stnolting/74xx_discrete_clock/schematic/clock_module.pdf

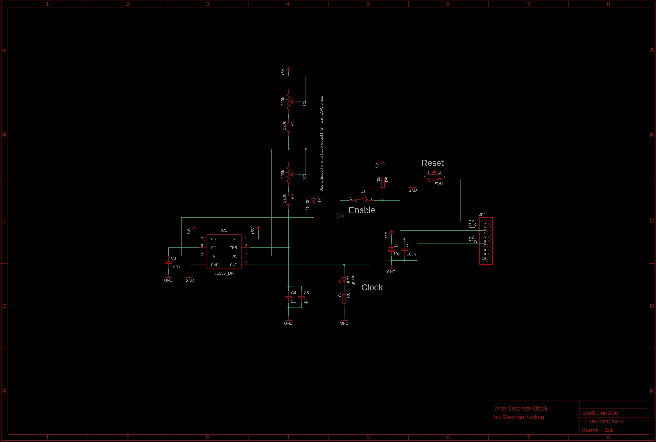
[picture p13: page 1]
