stnolting/74xx_discrete_clock/schematic/counter_module.pdf

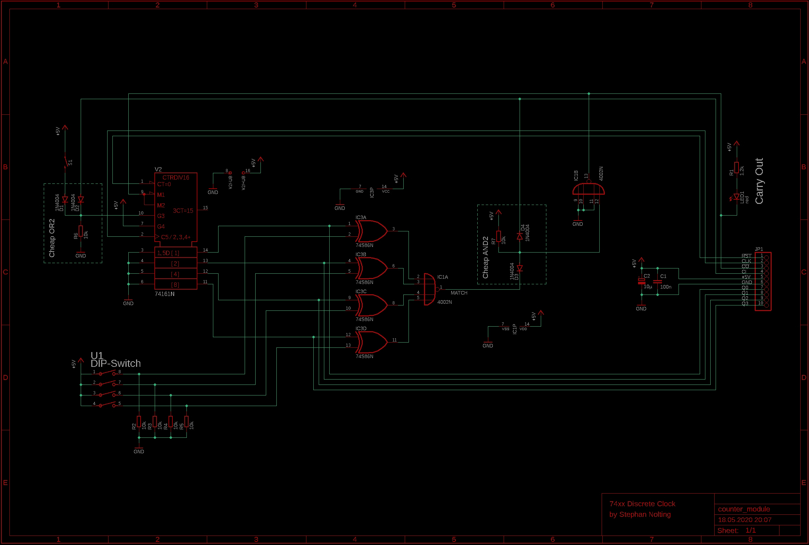
[picture p14: page 1]
