stnolting/74xx_discrete_clock/schematic/display_board.pdf

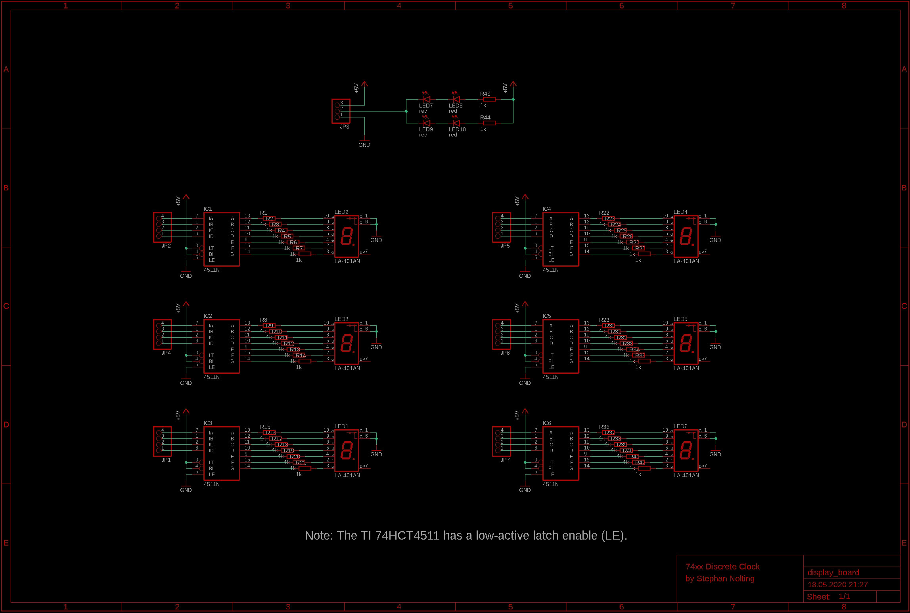
[picture p15: page 1]
