stnolting/74xx_discrete_clock/schematic/mother_board.pdf

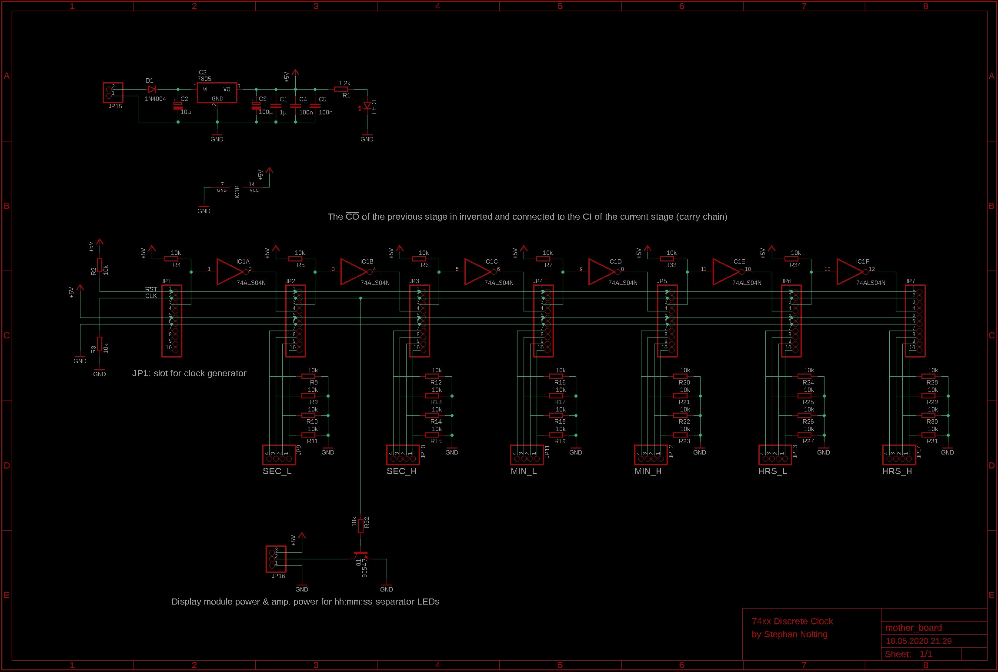
[picture p16: page 1]
