stnolting/74xx_discrete_clock/schematic/counter_module.png

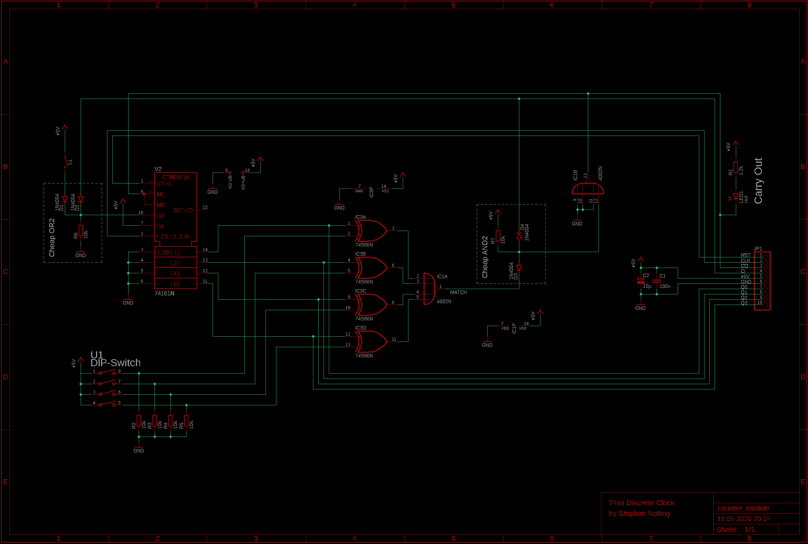
schematic/counter_module.png
