stnolting/74xx_discrete_clock/schematic/clock_module.sch

## EAGLE design schematic/clock_module.sch (2020-05-19)

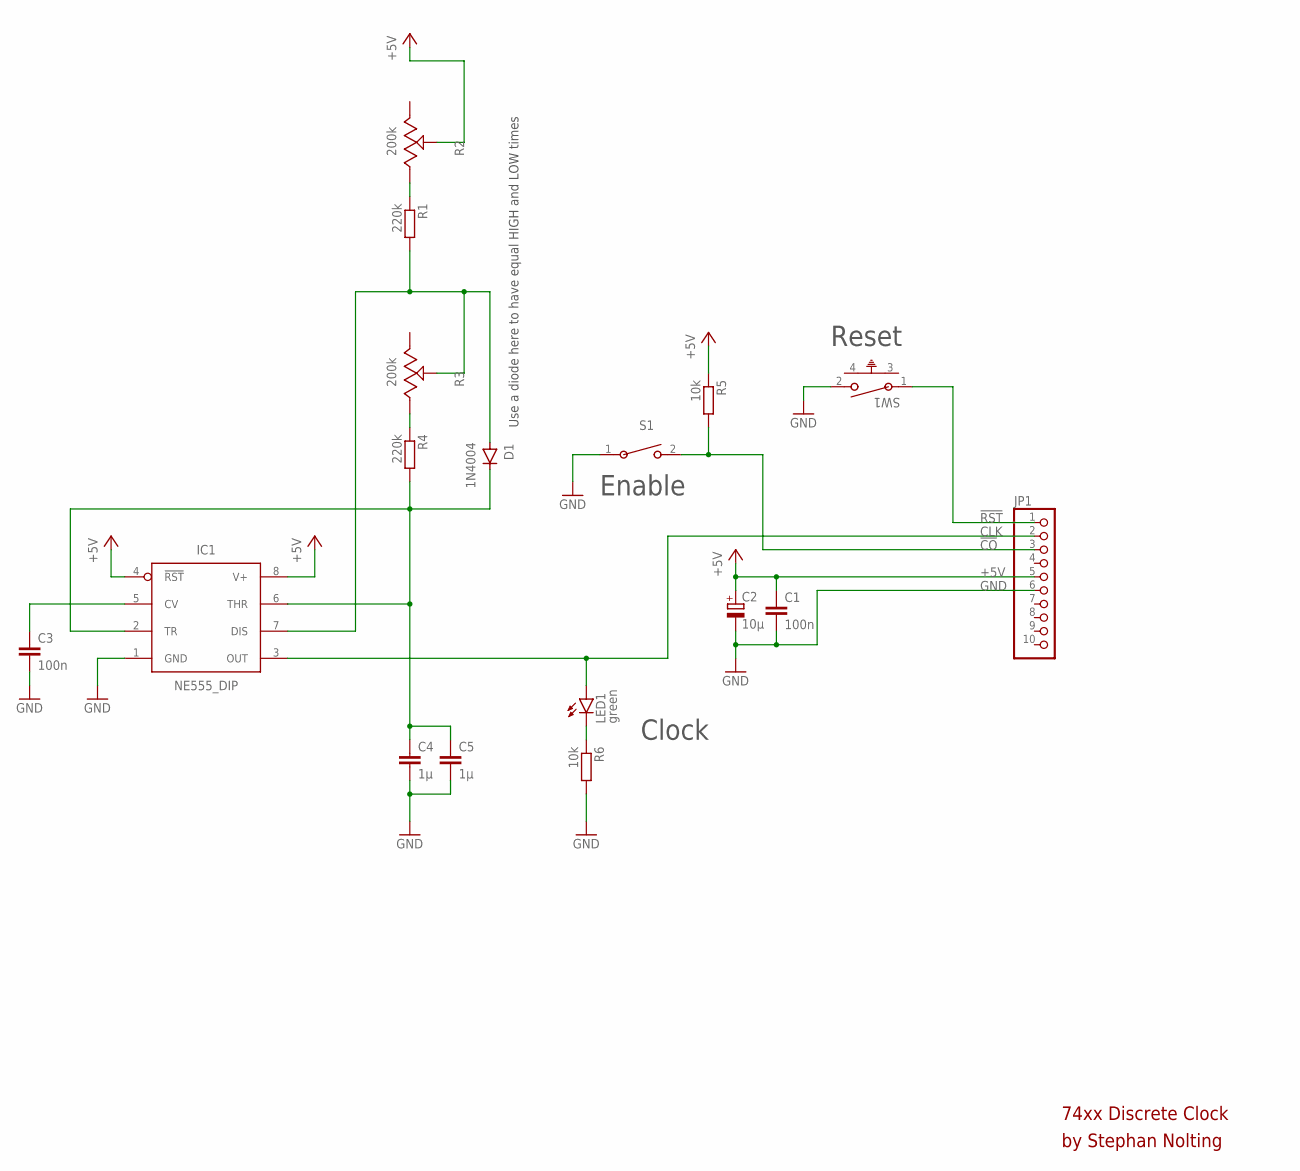
[picture p18: schematic clock_module.sch]

Parts:
C1, C3: 100n; C025-024X044
C2: 10µ; E2-5
C4, C5: 1µ; C025-024X044
D1: 1N4004; DO-41
IC1: NE555_DIP; DIP826W53P254L959H508Q8B
JP1: PINHD-1X10/90; 1X10/90
LED1: green; LED3MM
R1, R4: 220k; 0204/7
R2, R3: 200k; 3310Y-001-104L-ND
R5, R6: 10k; 0204/7
S1: 1825966-1; SWDIP2_256X170P100
SW1: 1-1825027-4; SW2_1825027-E

Connections:
!CO: JP1.3, R5.2, S1.2
!RST: JP1.1, SW1.1
+5V: C1.1, C2.+, IC1.4 (!RST), IC1.8 (V+), JP1.5, R2.2, R5.1
CLK: IC1.3 (OUT), JP1.2, LED1.A
GND: C1.2, C2.-, C3.2, C4.2, C5.2, IC1.1 (GND), JP1.6, R6.2, S1.1, SW1.2
unnamed: C3.1, IC1.5 (CV)
unnamed: R3.3, R4.1
unnamed: C4.1, C5.1, D1.C, IC1.2 (TR), IC1.6 (THR), R4.2
unnamed: R1.1, R2.3
unnamed: D1.A, IC1.7 (DIS), R1.2, R3.2
unnamed: LED1.K (C), R6.1

Notes on the sheet:
Enable
Reset
Clock
74xx Discrete Clock
by Stephan Nolting
Use a diode here to have equal HIGH and LOW times
