stnolting/74xx_discrete_clock/schematic/counter_module.sch

## EAGLE design schematic/counter_module.sch (2020-05-18)

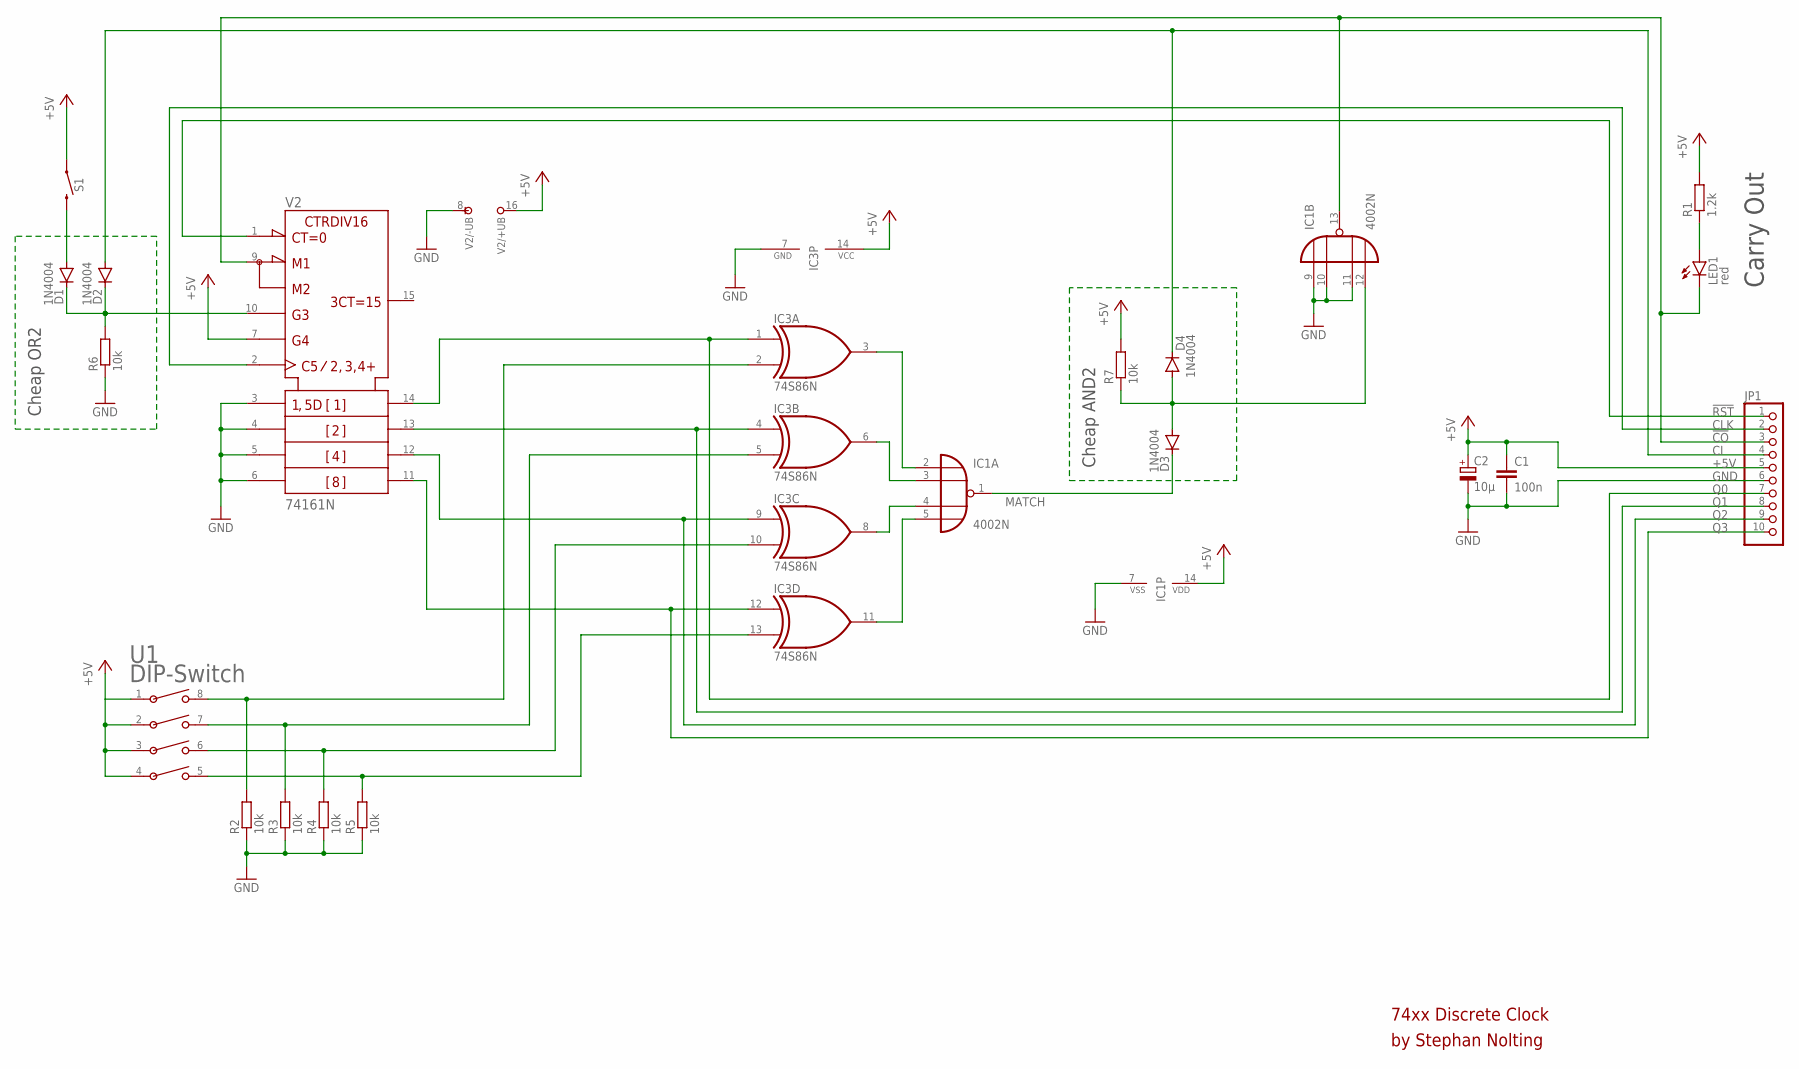
[picture p19: schematic counter_module.sch]

Parts:
C1: 100n; C025-024X044
C2: 10µ; E2-5
D1, D2, D3, D4: 1N4004; DO-41
IC1: 4002N; DIL14
IC3: 74S86N; DIL14
JP1: PINHD-1X10/90; 1X10/90
LED1: red; LED3MM
R1: 1.2k; 0204/7
R2, R3, R4, R5, R6, R7: 10k; 0204/7
S1: MOMENTARY-SWITCH-SPST-PTH-RIGHT-ANGLE-KIT; TACTILE_SWITCH_PTH_RIGHT_ANGLE_KIT
U1: DIP-Switch; SWDIP8_315X360P100
V2: 74161N; DIL16

Connections:
!CO: IC1.13 (O), JP1.3, LED1.K (C), V2.9 (!LOAD)
!RST: JP1.1, V2.1 (!CLR)
+5V: C1.1, C2.+, IC1.14 (VDD), IC3.14 (VCC), JP1.5, R1.2, R7.2, S1.1, U1.1, U1.2, U1.3, U1.4, V2.7 (ENP), V2.16 (+UB)
CI: D2.A, D4.C, JP1.4
CLK: JP1.2, V2.2 (CLK)
GND: C1.2, C2.-, IC1.7 (VSS), IC1.9 (I0), IC1.10 (I1), IC1.11 (I2), IC3.7 (GND), JP1.6, R2.1, R3.1, R4.1, R5.1, R6.1, V2.3 (A), V2.4 (B), V2.5 (C), V2.6 (D), V2.8 (-UB)
MATCH: D3.C, IC1.1 (O)
unnamed: IC1.3 (I1), IC3.6 (O)
unnamed: IC1.4 (I2), IC3.8 (O)
unnamed: IC1.5 (I3), IC3.11 (O)
unnamed: IC1.2 (I0), IC3.3 (O)
unnamed: IC3.2 (I1), R2.2, U1.8
unnamed: IC3.5 (I1), R3.2, U1.7
unnamed: IC3.10 (I1), R4.2, U1.6
unnamed: IC3.13 (I1), R5.2, U1.5
unnamed: D1.C, D2.C, R6.2, V2.10 (ENT)
unnamed: D1.A, S1.2
unnamed: LED1.A, R1.1
unnamed: D3.A, D4.A, IC1.12 (I3), R7.1
Q0: IC3.1 (I0), JP1.7, V2.14 (QA)
Q1: IC3.4 (I0), JP1.8, V2.13 (QB)
Q2: IC3.9 (I0), JP1.9, V2.12 (QC)
Q3: IC3.12 (I0), JP1.10, V2.11 (QD)

Notes on the sheet:
Cheap OR2
Cheap AND2
74xx Discrete Clock
by Stephan Nolting
Carry Out
