stnolting/74xx_discrete_clock/schematic/display_board.sch

## EAGLE design schematic/display_board.sch (2020-05-18)

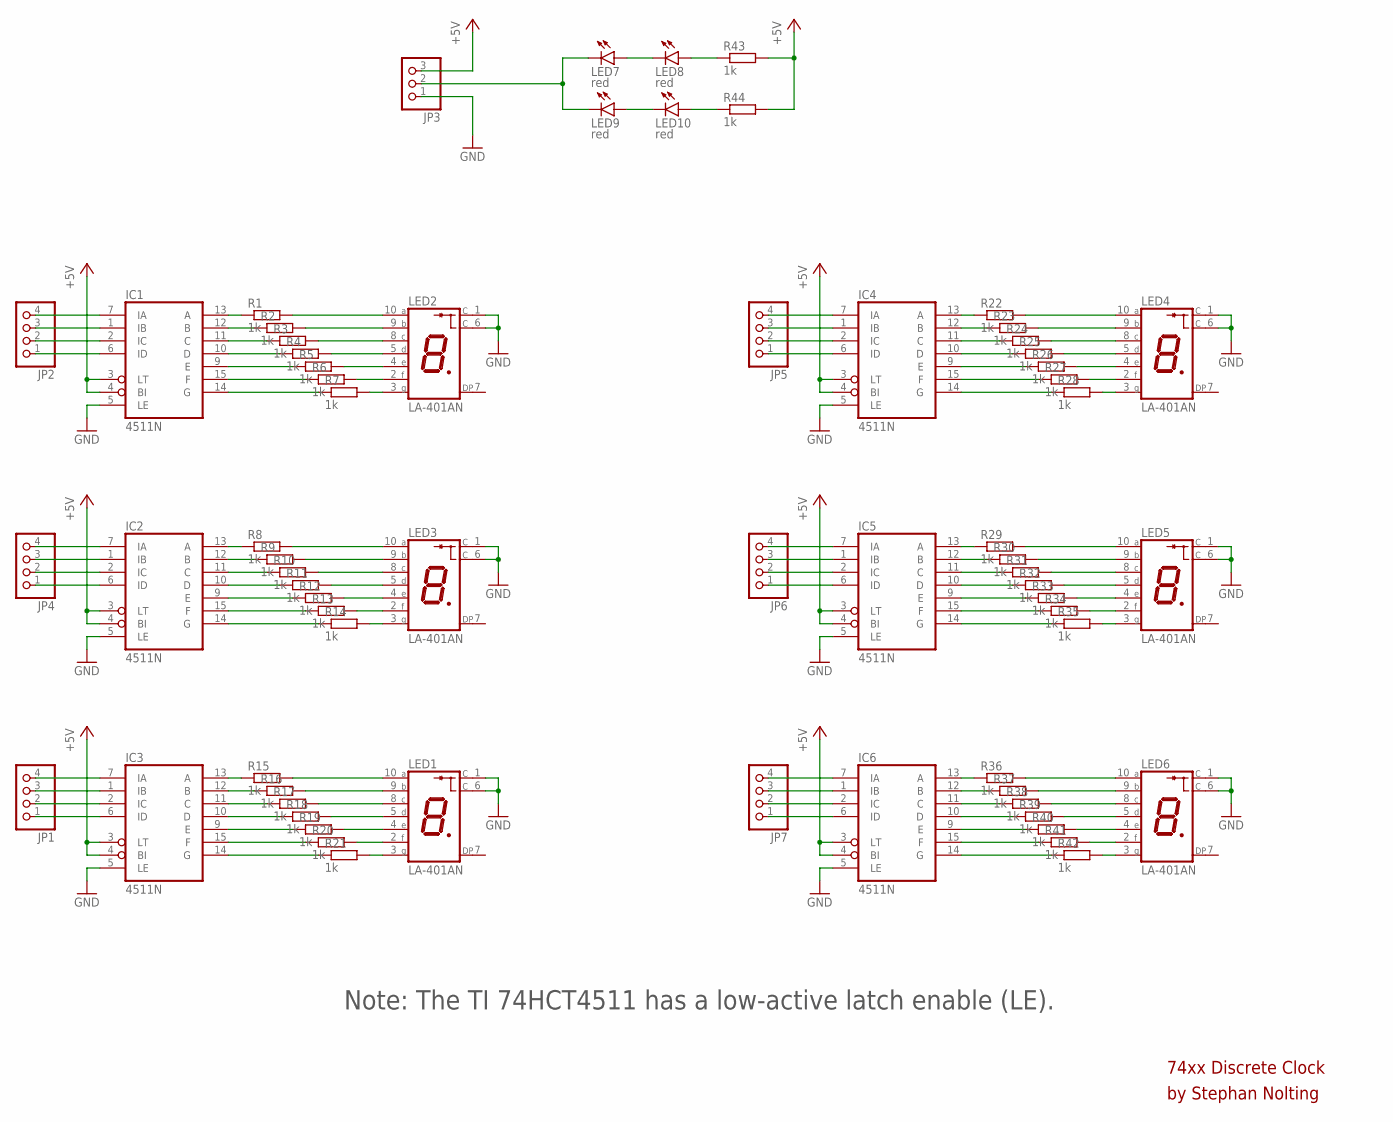
[picture p20: schematic display_board.sch]

Parts:
IC1, IC2, IC3, IC4, IC5, IC6: 4511N; DIL16
JP1, JP2, JP4, JP5, JP6, JP7: PINHD-1X4; 1X04
JP3: PINHD-1X3; 1X03
LED1, LED2, LED3, LED4, LED5, LED6: LA-401AN; LA-401
LED7, LED8, LED9, LED10: red; LED3MM
R1, R2, R3, R4, R5, R6, R7, R8, R9, R10, R11, R12, R13, R14, R15, R16, R17, R18, R19, R20, R21, R22, R23, R24, R25, R26, R27, R28, R29, R30, R31, R32, R33, R34, R35, R36, R37, R38, R39, R40, R41, R42, R43, R44: 1k; 0204/7

Connections:
+5V: IC1.3 (LT), IC1.4 (BI), IC2.3 (LT), IC2.4 (BI), IC3.3 (LT), IC3.4 (BI), IC4.3 (LT), IC4.4 (BI), IC5.3 (LT), IC5.4 (BI), IC6.3 (LT), IC6.4 (BI), JP3.3, R43.2, R44.2
GND: IC1.5 (LE), IC2.5 (LE), IC3.5 (LE), IC4.5 (LE), IC5.5 (LE), IC6.5 (LE), JP3.1, LED1.1 (C), LED1.6 (C), LED2.1 (C), LED2.6 (C), LED3.1 (C), LED3.6 (C), LED4.1 (C), LED4.6 (C), LED5.1 (C), LED5.6 (C), LED6.1 (C), LED6.6 (C)
unnamed: IC3.13 (A), R15.1
unnamed: IC3.12 (B), R16.1
unnamed: IC1.13 (A), R1.1
unnamed: IC1.12 (B), R2.1
unnamed: IC1.11 (C), R3.1
unnamed: IC1.10 (D), R4.1
unnamed: IC1.9 (E), R5.1
unnamed: IC1.15 (F), R6.1
unnamed: IC1.14 (G), R7.1
unnamed: LED2.10 (A), R1.2
unnamed: LED2.9 (B), R2.2
unnamed: LED2.8 (C), R3.2
unnamed: LED2.5 (D), R4.2
unnamed: LED2.4 (E), R5.2
unnamed: LED2.2 (F), R6.2
unnamed: LED2.3 (G), R7.2
unnamed: IC1.7 (IA), JP2.4
unnamed: IC1.1 (IB), JP2.3
unnamed: IC1.2 (IC), JP2.2
unnamed: IC1.6 (ID), JP2.1
unnamed: IC2.13 (A), R8.1
unnamed: IC2.12 (B), R9.1
unnamed: IC2.11 (C), R10.1
unnamed: IC2.10 (D), R11.1
unnamed: IC2.9 (E), R12.1
unnamed: IC2.15 (F), R13.1
unnamed: IC2.14 (G), R14.1
unnamed: LED3.10 (A), R8.2
unnamed: LED3.9 (B), R9.2
unnamed: LED3.8 (C), R10.2
unnamed: LED3.5 (D), R11.2
unnamed: LED3.4 (E), R12.2
unnamed: LED3.2 (F), R13.2
unnamed: LED3.3 (G), R14.2
unnamed: IC2.7 (IA), JP4.4
unnamed: IC2.1 (IB), JP4.3
unnamed: IC2.2 (IC), JP4.2
unnamed: IC2.6 (ID), JP4.1
unnamed: IC3.11 (C), R17.1
unnamed: IC3.10 (D), R18.1
unnamed: IC3.9 (E), R19.1
unnamed: IC3.15 (F), R20.1
unnamed: IC3.14 (G), R21.1
unnamed: LED1.10 (A), R15.2
unnamed: LED1.9 (B), R16.2
unnamed: LED1.8 (C), R17.2
unnamed: LED1.5 (D), R18.2
unnamed: LED1.4 (E), R19.2
unnamed: LED1.2 (F), R20.2
unnamed: LED1.3 (G), R21.2
unnamed: IC3.7 (IA), JP1.4
unnamed: IC3.1 (IB), JP1.3
unnamed: IC3.2 (IC), JP1.2
unnamed: IC3.6 (ID), JP1.1
unnamed: IC4.13 (A), R22.1
unnamed: IC4.12 (B), R23.1
unnamed: IC4.11 (C), R24.1
unnamed: IC4.10 (D), R25.1
unnamed: IC4.9 (E), R26.1
unnamed: IC4.15 (F), R27.1
unnamed: IC4.14 (G), R28.1
unnamed: LED4.10 (A), R22.2
unnamed: LED4.9 (B), R23.2
unnamed: LED4.8 (C), R24.2
unnamed: LED4.5 (D), R25.2
unnamed: LED4.4 (E), R26.2
unnamed: LED4.2 (F), R27.2
unnamed: LED4.3 (G), R28.2
unnamed: IC4.7 (IA), JP5.4
unnamed: IC4.1 (IB), JP5.3
unnamed: IC4.2 (IC), JP5.2
unnamed: IC4.6 (ID), JP5.1
unnamed: IC5.13 (A), R29.1
unnamed: IC5.12 (B), R30.1
unnamed: IC5.11 (C), R31.1
unnamed: IC5.10 (D), R32.1
unnamed: IC5.9 (E), R33.1
unnamed: IC5.15 (F), R34.1
unnamed: IC5.14 (G), R35.1
unnamed: LED5.10 (A), R29.2
unnamed: LED5.9 (B), R30.2
unnamed: LED5.8 (C), R31.2
unnamed: LED5.5 (D), R32.2
unnamed: LED5.4 (E), R33.2
unnamed: LED5.2 (F), R34.2
unnamed: LED5.3 (G), R35.2
unnamed: IC5.7 (IA), JP6.4
unnamed: IC5.1 (IB), JP6.3
unnamed: IC5.2 (IC), JP6.2
unnamed: IC5.6 (ID), JP6.1
unnamed: IC6.13 (A), R36.1
unnamed: IC6.12 (B), R37.1
unnamed: IC6.11 (C), R38.1
unnamed: IC6.10 (D), R39.1
unnamed: IC6.9 (E), R40.1
unnamed: IC6.15 (F), R41.1
unnamed: IC6.14 (G), R42.1
unnamed: LED6.10 (A), R36.2
unnamed: LED6.9 (B), R37.2
unnamed: LED6.8 (C), R38.2
unnamed: LED6.5 (D), R39.2
unnamed: LED6.4 (E), R40.2
unnamed: LED6.2 (F), R41.2
unnamed: LED6.3 (G), R42.2
unnamed: IC6.7 (IA), JP7.4
unnamed: IC6.1 (IB), JP7.3
unnamed: IC6.2 (IC), JP7.2
unnamed: IC6.6 (ID), JP7.1
unnamed: JP3.2, LED7.K (C), LED9.K (C)
unnamed: LED7.A, LED8.K (C)
unnamed: LED8.A, R43.1
unnamed: LED9.A, LED10.K (C)
unnamed: LED10.A, R44.1

Notes on the sheet:
74xx Discrete Clock
by Stephan Nolting
Note: The TI 74HCT4511 has a low-active latch enable (LE).
