stnolting/74xx_discrete_clock/schematic/mother_board.sch

## EAGLE design schematic/mother_board.sch (2020-05-18)

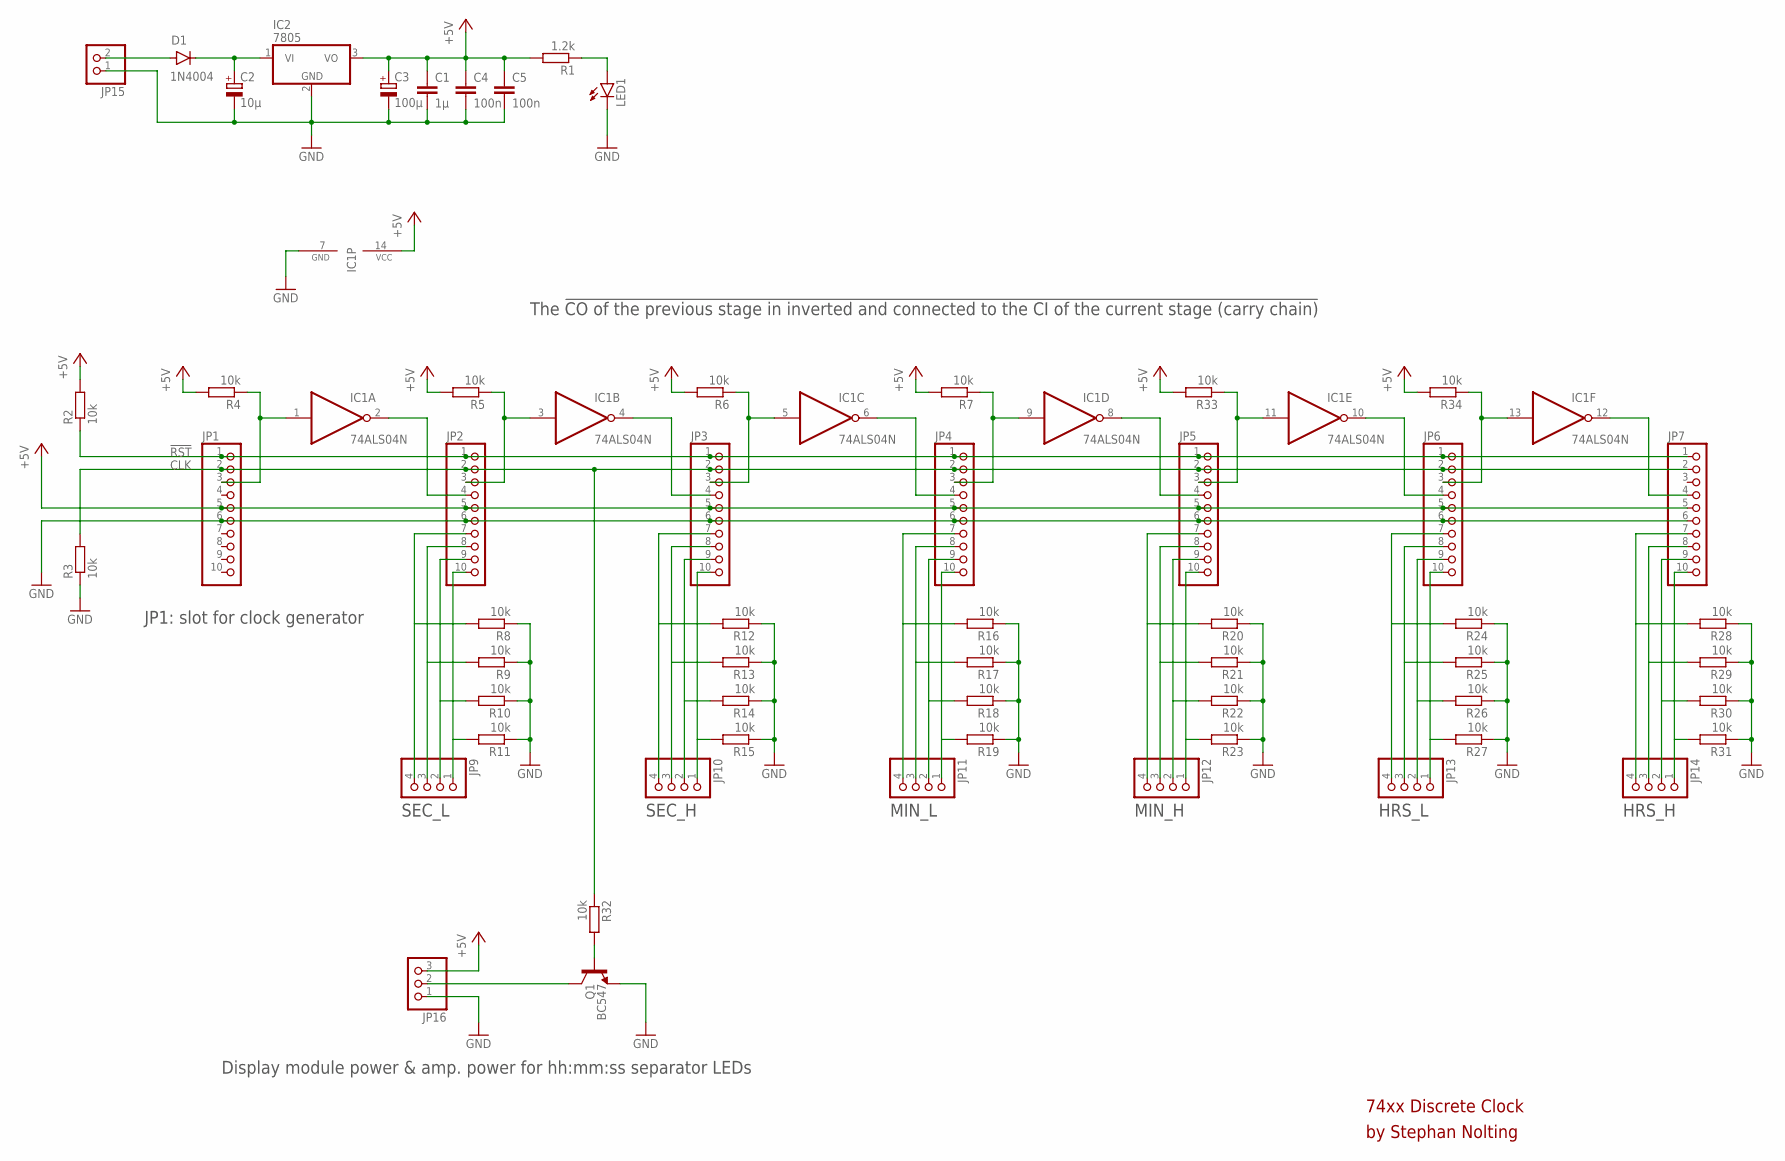
[picture p21: schematic mother_board.sch]

Parts:
C1: 1µ; C025-024X044
C2: 10µ; E2-5
C3: 100µ; E2-5
C4, C5: 100n; C025-024X044
D1: 1N4004; DO-41
IC1: 74ALS04N; DIL14
IC2: 7805; TO220V
JP1, JP2, JP3, JP4, JP5, JP6, JP7: PINHD-1X10/90; 1X10/90
JP9, JP10, JP11, JP12, JP13, JP14: PINHD-1X4; 1X04
JP15: PINHD-1X2; 1X02
JP16: PINHD-1X3; 1X03
LED1: LED3MM
Q1: BC547; TO-92
R1: 1.2k; 0204/7
R2, R3, R4, R5, R6, R7, R8, R9, R10, R11, R12, R13, R14, R15, R16, R17, R18, R19, R20, R21, R22, R23, R24, R25, R26, R27, R28, R29, R30, R31, R32, R33, R34: 10k; 0204/7

Connections:
!RST: JP1.1, JP2.1, JP3.1, JP4.1, JP5.1, JP6.1, JP7.1, R2.1
+5V: C1.1, C3.+, C4.1, C5.1, IC1.14 (VCC), IC2.3 (VO), JP1.5, JP2.5, JP3.5, JP4.5, JP5.5, JP6.5, JP7.5, JP16.3, R1.2, R2.2, R4.2, R5.2, R6.2, R7.2, R33.2, R34.2
CLK: JP1.2, JP2.2, JP3.2, JP4.2, JP5.2, JP6.2, JP7.2, R3.2, R32.1
GND: C1.2, C2.-, C3.-, C4.2, C5.2, IC1.7 (GND), IC2.2 (GND), JP1.6, JP2.6, JP3.6, JP4.6, JP5.6, JP6.6, JP7.6, JP15.1, JP16.1, LED1.K (C), Q1.1 (E), R3.1, R8.1, R9.1, R10.1, R11.1, R12.1, R13.1, R14.1, R15.1, R16.1, R17.1, R18.1, R19.1, R20.1, R21.1, R22.1, R23.1, R24.1, R25.1, R26.1, R27.1, R28.1, R29.1, R30.1, R31.1
unnamed: LED1.A, R1.1
unnamed: JP7.10, JP14.1
unnamed: JP7.9, JP14.2
unnamed: JP7.8, JP14.3
unnamed: JP7.7, JP14.4
unnamed: JP6.10, JP13.1
unnamed: JP6.9, JP13.2
unnamed: JP6.8, JP13.3
unnamed: JP6.7, JP13.4
unnamed: JP5.10, JP12.1
unnamed: JP5.9, JP12.2
unnamed: JP5.8, JP12.3
unnamed: JP5.7, JP12.4
unnamed: JP4.10, JP11.1
unnamed: JP16.2, Q1.3 (C)
unnamed: JP4.9, JP11.2
unnamed: JP4.8, JP11.3
unnamed: JP4.7, JP11.4
unnamed: JP3.10, JP10.1
unnamed: JP3.9, JP10.2
unnamed: JP3.8, JP10.3
unnamed: JP3.7, JP10.4
unnamed: JP2.10, JP9.1
unnamed: JP2.9, JP9.2
unnamed: JP2.8, JP9.3
unnamed: JP2.7, JP9.4
unnamed: IC1.1 (I), JP1.3, R4.1
unnamed: IC1.2 (O), JP2.4
unnamed: IC1.3 (I), JP2.3, R5.1
unnamed: IC1.4 (O), JP3.4
unnamed: IC1.5 (I), JP3.3, R6.1
unnamed: IC1.6 (O), JP4.4
unnamed: IC1.9 (I), JP4.3, R7.1
unnamed: IC1.8 (O), JP5.4
unnamed: IC1.11 (I), JP5.3, R33.1
unnamed: IC1.10 (O), JP6.4
unnamed: IC1.13 (I), JP6.3, R34.1
unnamed: IC1.12 (O), JP7.4
unnamed: D1.A, JP15.2
unnamed: C2.+, D1.C, IC2.1 (VI)
unnamed: Q1.2 (B), R32.2

Notes on the sheet:
Display module power & amp. power for hh:mm:ss separator LEDs
The !CO of the previous stage in inverted and connected to the CI of the current stage (carry chain)
74xx Discrete Clock
by Stephan Nolting
JP1: slot for clock generator
SEC_L
SEC_H
MIN_L
MIN_H
HRS_L
HRS_H
