stnolting/74xx_discrete_clock/(commit log)

2020-05-18 added first draft of counter module schematics
    [counter_module.sch]
2020-05-18 added mother and display board
    [display_board.sch, mother_board.sch]
2020-05-19 added clock module
    [clock_module.sch]
2020-05-19 added assembled clock images
2020-05-19 added schematics as pdfs
2020-08-05 clock calibration and evaluation done
