stnolting/74xx_discrete_clock/(notices)

Notices in the files:
parts and their libraries:
Switches: COPYRIGHT: Copyright (C) 2016 Accelerated Designs. All rights reserved
SparkFun-Switches: Licensing: Creative Commons ShareAlike 4.0 International - https://creativecommons.org/licenses/by-sa/4.0
